basement-tech/Monitoring-zimKnives/README.md

# Monitoring-zimKnives
Remotely monitoring a remote shop and doing some automatic alarming and notification
This project combines a remote monitoring unit (ESP-8266 based) with python code running
on a Raspberry Pi and Mosquitto to provide a remote monitoring capability and some alarming functions.
NodeRed is used for visualization and remote control.
See the current system diagram in the docs folder

    This file is part of the "Monitoring zimKnives" project, which is a collection
    of files, including this one, collected in the Monitoring-zimKnives github project.

    This program is free software: you can redistribute it and/or modify
    it under the terms of these words as published by the author.

    This program is distributed in the hope that it will be useful,
    but WITHOUT ANY WARRANTY; without even the implied warranty of
    MERCHANTABILITY or FITNESS FOR A PARTICULAR PURPOSE.  Use at your own risk.
