basement-tech/Monitoring-zimKnives/docs/README

Contains docs related to the Monitoring-zimKnives project.
Files of all kinds: diagrams, 3D printed designs, etc.
Code is located in other places.

Videos can be found in the "basement tech" youTube channel.

This diagrams are free: you can redistribute it and/or modify
it under the terms of these words as published by the author.

The designs contained herein are distributed in the hope that it will be useful,
but WITHOUT ANY WARRANTY; without even the implied warranty of
MERCHANTABILITY or FITNESS FOR A PARTICULAR PURPOSE.  Use at your own risk.

Since electricity is involved, please consult an expert with regard to construction,
modification, testing and use.  If you don't know what you are doing, please
seek help and/or advice from someone who does.

With respect to soldering, please take all appropriate safety precautions.

For all equipment, read and understand all safety and use information provided by the
manufacturer.
