basement-tech/Monitoring-zimKnives/docs/BaseUnitInterface.pdf

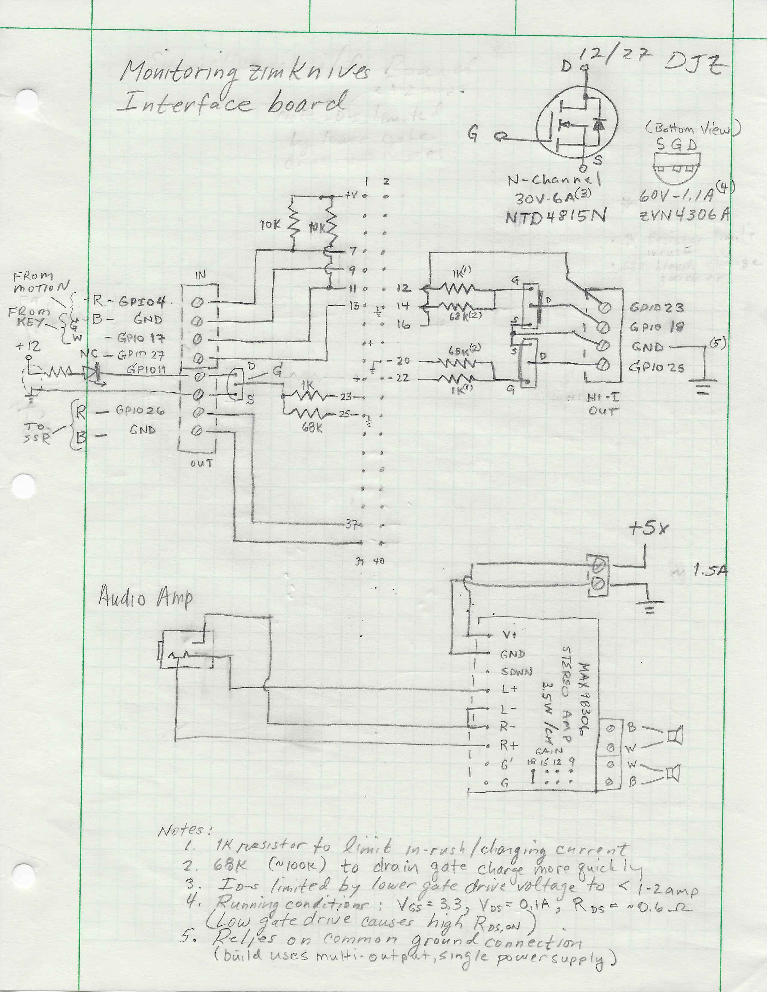
[picture p1: page 1]
