basement-tech/Monitoring-zimKnives/docs/RemoteTHGModule.pdf

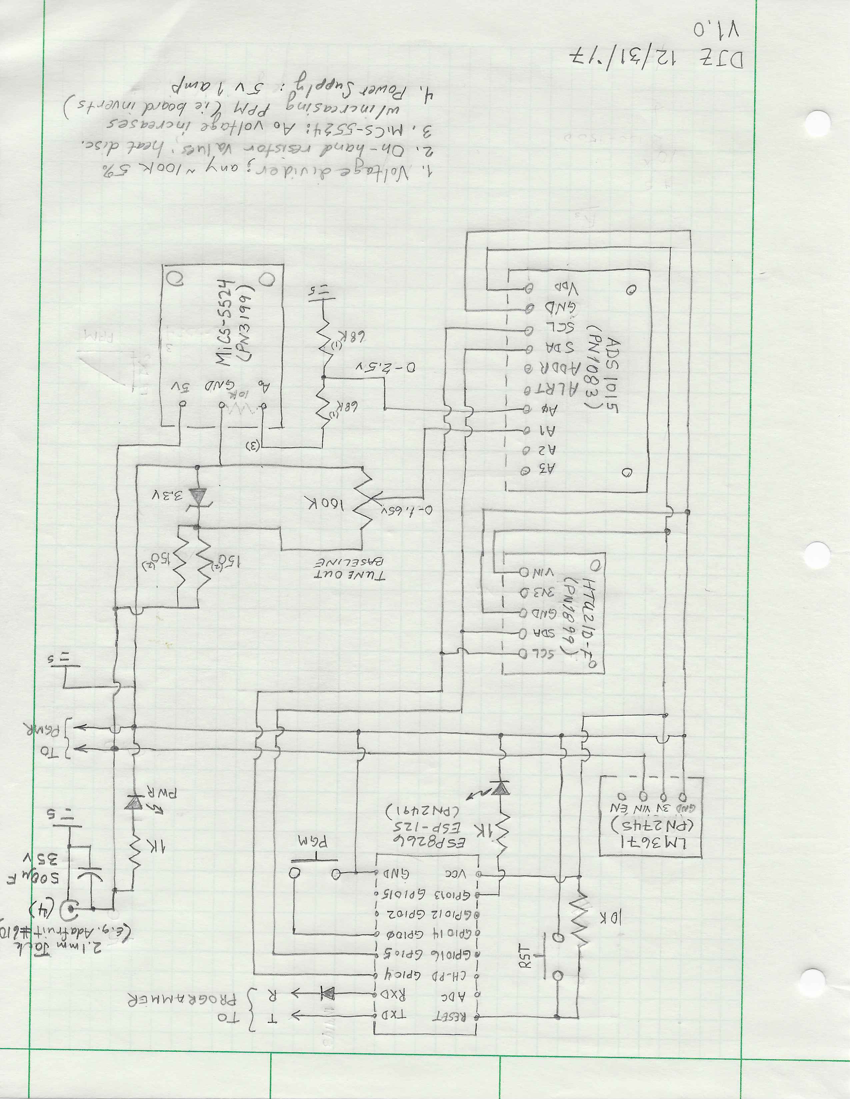
[picture p2: page 1]
