basement-tech/Monitoring-zimKnives/docs/MonitoringSystemDiagram.pdf

## January12, 2018 DJZ

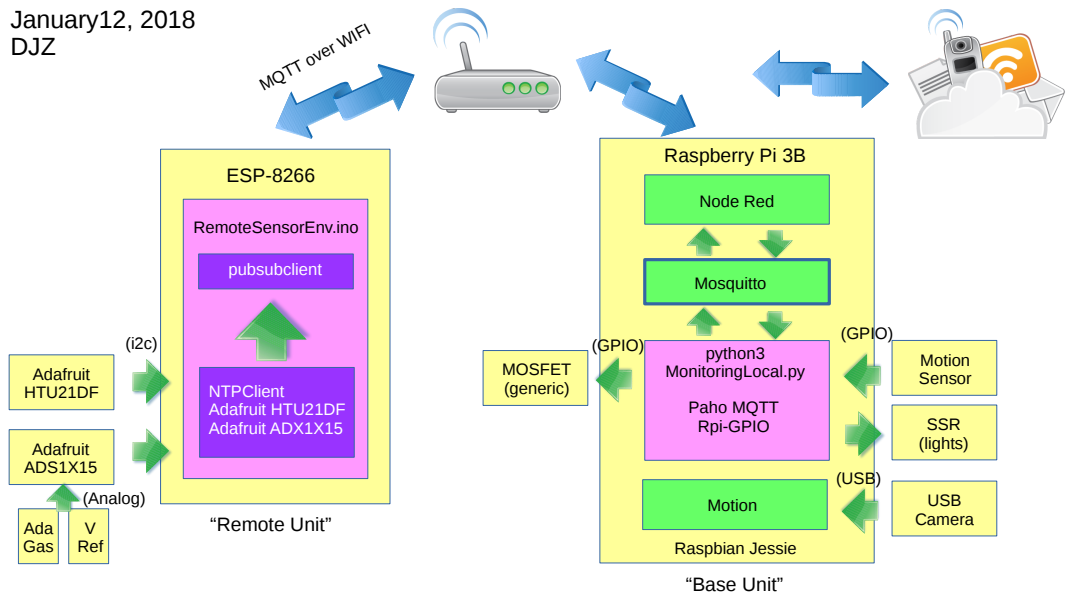
[picture p3: page 1]
Raspberry Pi 3B; Node Red; Mosquitto; Raspbian Jessie; python3 MonitoringLocal.py; ESP-8266; RemoteSensorEnv.ino; Adafruit HTU21DF; Adafruit ADS1X15; NTPClient Adafruit HTU21DF Adafruit ADX1X15; pubsubclient; USB Camera; Motion Sensor; Motion; Paho MQTT; Rpi-GPIO; SSR; (lights); MOSFET (generic); Ada Gas; V Ref; (GPIO); (USB); (Analog); “Remote Unit”; “Base Unit”

MQTT over WIFI
