basement-tech/Monitoring-zimKnives/code/ESP8266/RemoteEnvSensorESP_v2.1/disp_settings.h

/**The MIT License (MIT)
 
 Copyright (c) 2018 by ThingPulse Ltd., https://thingpulse.com
 
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
 THE SOFTWARE IS PROVIDED "AS IS", WITHOUT WARRANTY OF ANY KIND, EXPRESS OR
 IMPLIED, INCLUDING BUT NOT LIMITED TO THE WARRANTIES OF MERCHANTABILITY,
 FITNESS FOR A PARTICULAR PURPOSE AND NONINFRINGEMENT. IN NO EVENT SHALL THE
 AUTHORS OR COPYRIGHT HOLDERS BE LIABLE FOR ANY CLAIM, DAMAGES OR OTHER
 LIABILITY, WHETHER IN AN ACTION OF CONTRACT, TORT OR OTHERWISE, ARISING FROM,
 OUT OF OR IN CONNECTION WITH THE SOFTWARE OR THE USE OR OTHER DEALINGS IN THE
 SOFTWARE.
 */

#include <Arduino.h>

const int UPDATE_INTERVAL_SECS = 10 * 60; // Update every 10 minutes
const int SLEEP_INTERVAL_SECS = 0;        // Going to sleep after idle times, set 0 for insomnia

// values in metric or imperial system?
bool IS_METRIC = false;

// Change for 12 Hour/ 24 hour style clock
bool IS_STYLE_12HR = false;

// Change for HH:MM/ HH:MM:SS format clock
bool IS_STYLE_HHMM = false; // true => HH:MM

// Adjust according to your language
const String WDAY_NAMES[] = {"SUN", "MON", "TUE", "WED", "THU", "FRI", "SAT"};
const String MONTH_NAMES[] = {"JAN", "FEB", "MAR", "APR", "MAY", "JUN", "JUL", "AUG", "SEP", "OCT", "NOV", "DEC"};

// Pins for the ILI9341
#define TFT_DC D2
#define TFT_CS D1
#define TFT_LED D8

#define HAVE_TOUCHPAD
#define TOUCH_CS D3
#define TOUCH_IRQ  D4


/***************************
 * End Settings
 **************************/
