basement-tech/Monitoring-zimKnives/(commit log)

2018-01-28 Add files via upload
    # v0.5:
    # + added conf["LOCATION"] to be more specific with messages
    # + added sending email messages on motion event ... it works !
    # + added the holdoff timer for the motion event ... cool !
    # + added periodic notification of t/h/g values
    # + corrected bug where subscribed parameters were all being set as raw strings
    # + moved all of the hardware i/o to the MonitoringParameters Env() class
    # + made json decoding option in the on_message method
    # + fixed a bug using bool() with strings in on_message
    # + finish up the override logic for light and auto
    #
    [MonitoringParameters.py, Monitoring_conf.py, Monitoring_local.py]
2018-01-28 Add files via upload
    New timer class ... cleaner
2018-01-29 Add files via upload
    # + created timer class for reusability and auto-False cleanup
    # + added on_disconnect, callback for mqtt broker: attempt reconnect in main loop
    # + added a mqtt_con_status and use it to try to reconnect if connection is lost
    # + had to add catching of ConnectionRefusedError exception in order to keep things moving
    # on MQTT conneciton attempt (testing by first killing mosquitto data broker) ... cool !
    [MonitoringParameters.py, Monitoring_local.py]
2018-04-29 Add files via upload
    New functionality:
    expanded json data packet
    timestamp with every sample
    limits on parameters that send alert text messages
2019-11-16 Arduino IDE added subdir
2019-11-16 monitor estop signal and light NeoPixel LEDs accordingly
2019-11-17 cleaned up thermistor conversion code
2019-11-17 thermistors sent via mqtt/json
2019-11-17 consistent loop/sample interval
2019-11-19 accomodated millis() roll over
2019-11-21 replaced delay() in loop() with a timer
    [RemoteEnvSensorESP_v1.1.ino]
2019-11-21 timers, fast/slow loops and debug msg switches
2019-11-24 Testing under Arduino 1.8.10 and added more comments
2020-03-15 Topics for cnc router and wifi fail reboot
    Added topics for the cnc router so it can coexist in the data broker with existing env sensor. Added some wifi retry and device reboot on fail.
    [RemoteEnvSensorESP_v1.3.ino]
2020-03-15 Device reset on mqtt repeated fails
    Optional device reset on mqtt repeated fails
    [RemoteEnvSensorESP_v1.3.ino]
2020-03-19 INA169 current monitoring now supported
    INA169 current monitoring now supported
2020-03-21 Current Measurement and Neopixels
    Added basic support for current measurement and setting the color of neopixels based on current
2020-03-22 Instantaneous current for Neos
2020-03-28 Multiple incoming MQTT topics and error handling
    Added the ability to process incoming messages from multiple mqtt topics, better error handling, fleshed out the neopxl_mode functionality.
    [RemoteEnvSensorESP_v1.3.ino]
2020-03-28 Neopixel colors from current gain setting
    Added a parameter set by nodered/mqtt to adjust the current value that is mapped to the top color in the palette ... soooo cool !
2020-03-31 BUG FIX, faster looping, cleaned up
    Fixed an insidious little bug related to terminating strings in the json parser; made things a little more efficient; decreased looping interval to 50mS
    [RemoteEnvSensorESP_v1.3.ino]
2020-05-07 Interrupt tweeks
    Added "volatile" qualifier to variables that the ISR manipulates
2020-05-18 Fixed WIFI LED pin selection bug
    [RemoteEnvSensorESP_v1.4.ino]
2021-06-01 continued development and new version of some arduino libs
2021-08-28 start of 2.0 with separate libs; doesn't work yet
    [RemoteEnvSensorESP_v2.0.ino]
2022-07-27 mqtt re-subscribe on connect fail
    [RemoteEnvSensorESP_v2.0.ino]
2024-08-21 define for graphics board
2024-08-25 defines timestamp and WIFI LED
